Zighhi/Interactive-Plant-Installation/Hardware/Layout BOM.xls

Name | Value | Quantity | Notes
7660, TL084, TL084 |  | 3
Perf Board w/ Pads | - Pin 5 of RP2040-Zero (PH3) is not connected specifically to avoid shorting it to the -5V rail | 1
C1, C2 | 10uF | 2
C3, C4, C5, C6, C7, C10, C11, C12, C13, C14, C15, C16, C17, C18, C20, C21, C22 | 100nF | 17
C8, C9 | 47uF | 2
C19, C23, C24 | 1uF | 3
J1 | Stereo | 1
PH1, PH1 (Pins 15-32), PH2 (Pins 8-14), PH3 (Pins 0-7) |  | 4 | 23 + 3
R1, R2, R3, R4, R5, R12, R13 | 1M | 7
R6, R7, R8, R9, R10, R11, R23, R29, R30, R31, R32 | 100K | 11
R14, R16 | 30K | 2
R15, R17, R20 | 36K | 3
R18, R19 | 1K | 2
R21, R22, R27, R28 | 47K | 4
R24 | 120K | 1
R25 | 3M | 1
R26 | 1.2K | 1
Wavehare RP2040-zero | - | 1
