Zighhi/Interactive-Plant-Installation/Hardware/Layout.pdf

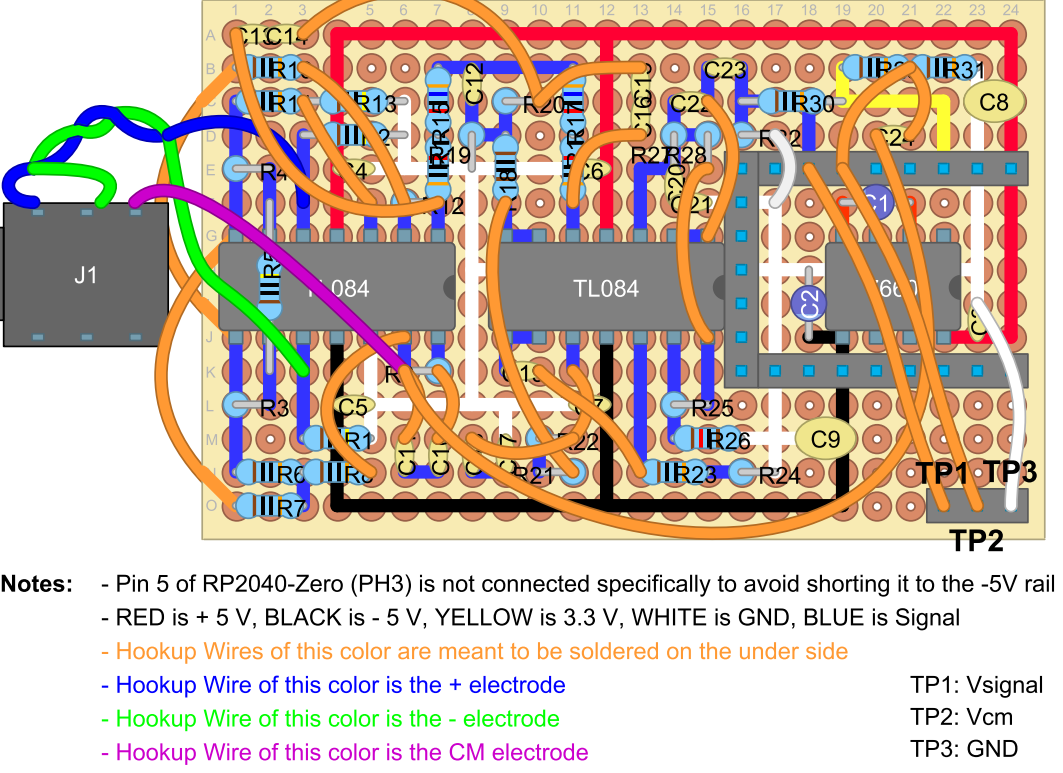
[picture p12: page 1]
