Zighhi/Interactive-Plant-Installation/Hardware/InstrumentationAmp.asc

10u: cap; 1µ
C1: cap; 50n
C2: cap; 100n
C3: cap; 1µ
C4: cap; 50n
C5: cap; 50n
C6: cap; 100n
C7: cap; 100n
C8: cap; 50n
C10: cap; 50n
R1: res; 1Meg
R2: res; 1Meg
R3: res; 1Meg
R4: res; 47k
R5: res; 100k
R6: res; 100k
R7: res; 1Meg
R8: res; 100k
R9: res; 1Meg
R10: res; 100k
R11: res; 47k
R12: res; 47k
R13: res; 220k
R16: res; 3Meg
R17: res; 1.2k
R18: res; 100k
R19: res; 47k
R20: res; 100k
R21: res; 100k
R22: res; 100k
R27: res; 66k
R28: res; 66k
R29: res; 36k
R30: res; 1k
R31: res; 1k
U1: ADTL084
U2: ADTL084
U3: ADTL084
U4: ADTL084
U5: ADTL082
U6: ADTL084
U7: ADTL084
U8: ADTL084
V3: voltage; 5
V4: voltage; 5
V5: voltage; 3.3
Named nets: 0, 5V, -5v, 5v, 3.3, Vsgn, 3.3V, Electod+, Electod-, RLD, ADC_Ch1, ADC_Ch2
.ac oct 100 1 200
