Zighhi/Interactive-Plant-Installation/(commit log)

2025-05-16 added everything
    [Layout BOM.xls]
2025-05-16 Added the .csv Recs and modified the Readme file
    [Baseline0.csv, Baseline1.csv, Baseline10.csv, Baseline100.csv, Baseline11.csv, Baseline12.csv, Baseline13.csv, Baseline14.csv]
